ichoi02/MeowMentumV2/cmds.png

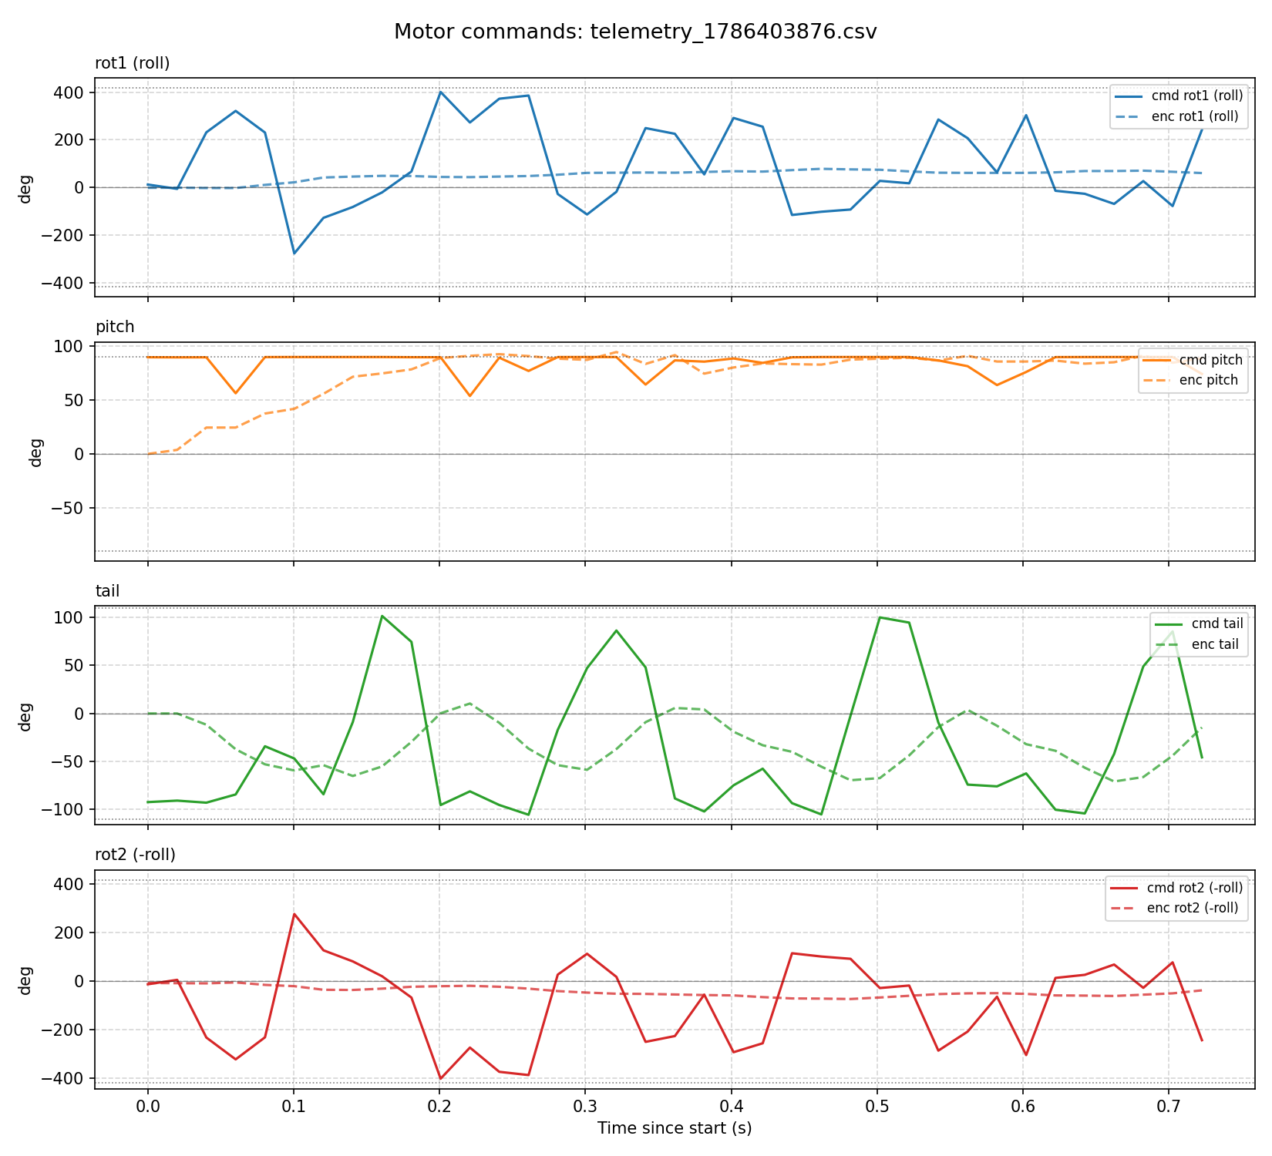
cmds.png
