ichoi02/MeowMentumV2/telemetry/sim2real_summary.png

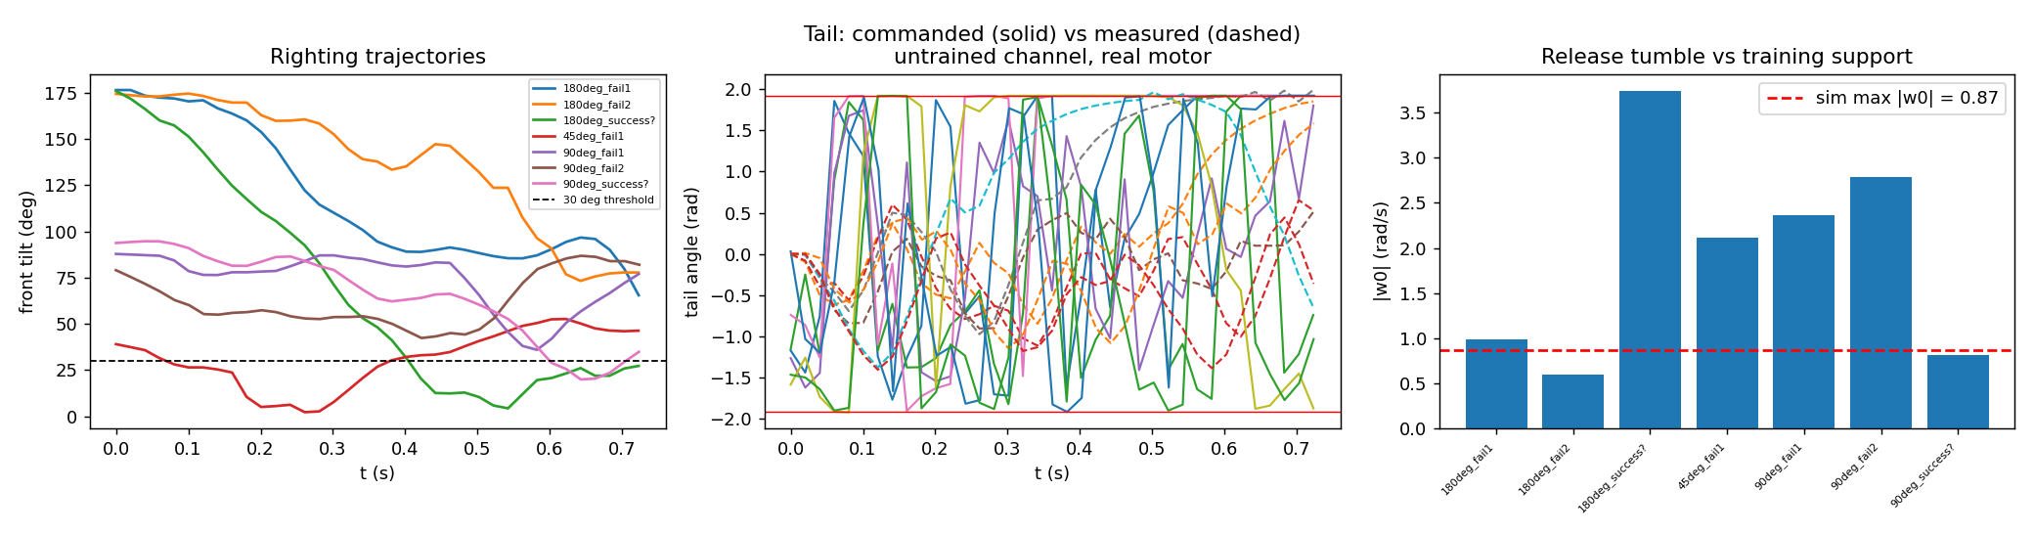
telemetry/sim2real_summary.png
