ichoi02/MeowMentumV2/telemetry/stage4_tracking.png

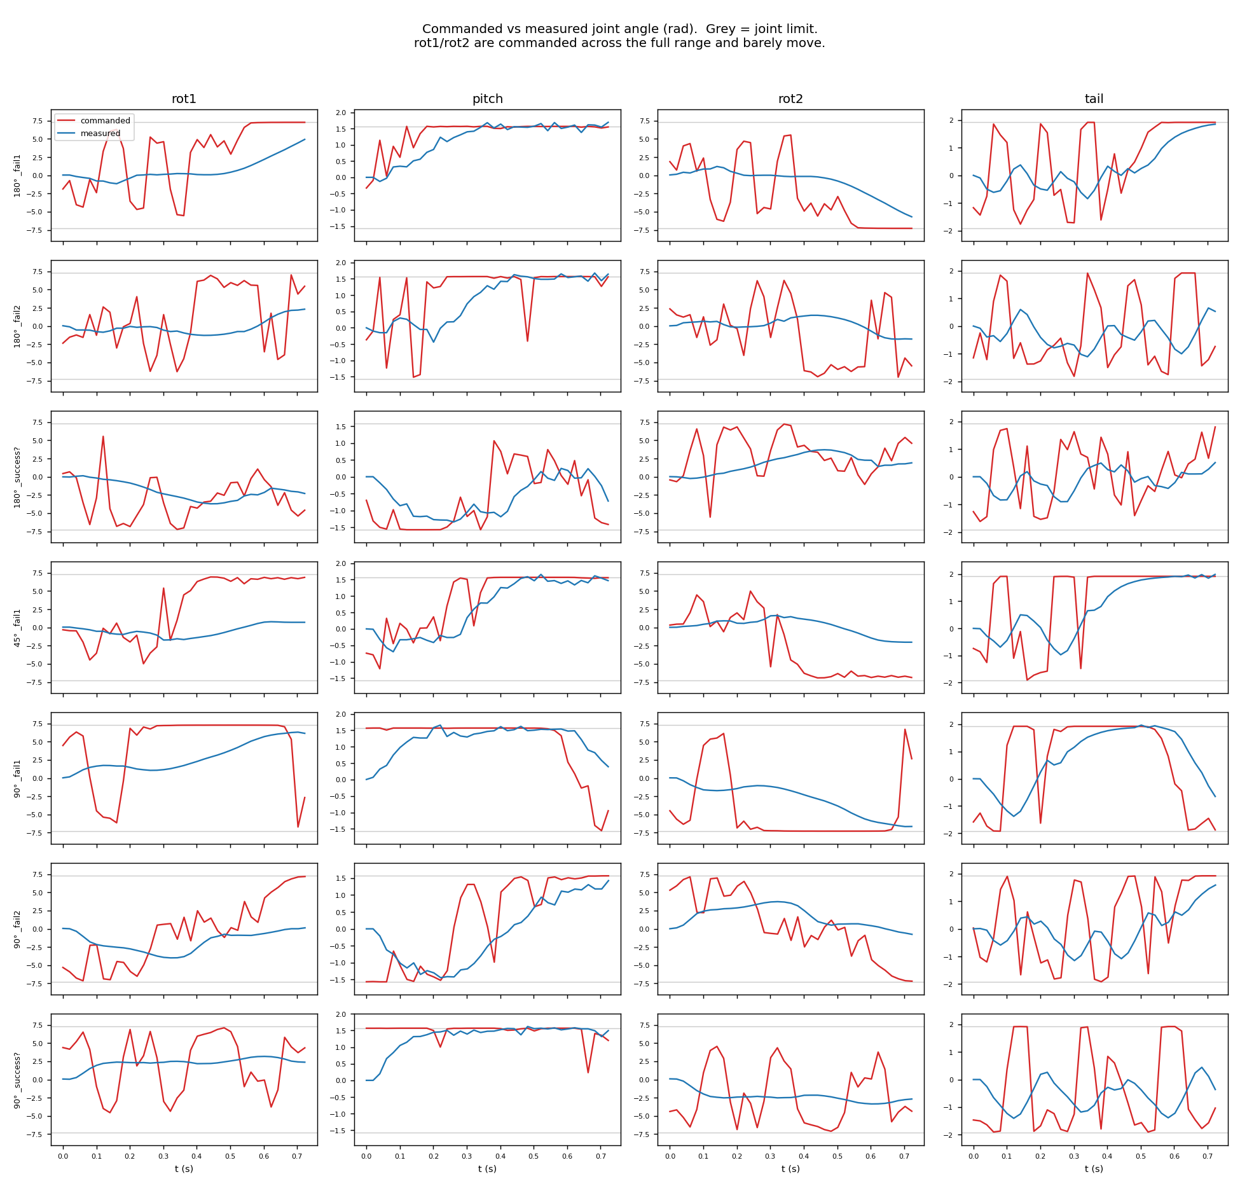
telemetry/stage4_tracking.png
