ichoi02/MeowMentumV2/telemetry/stage4_travel.png

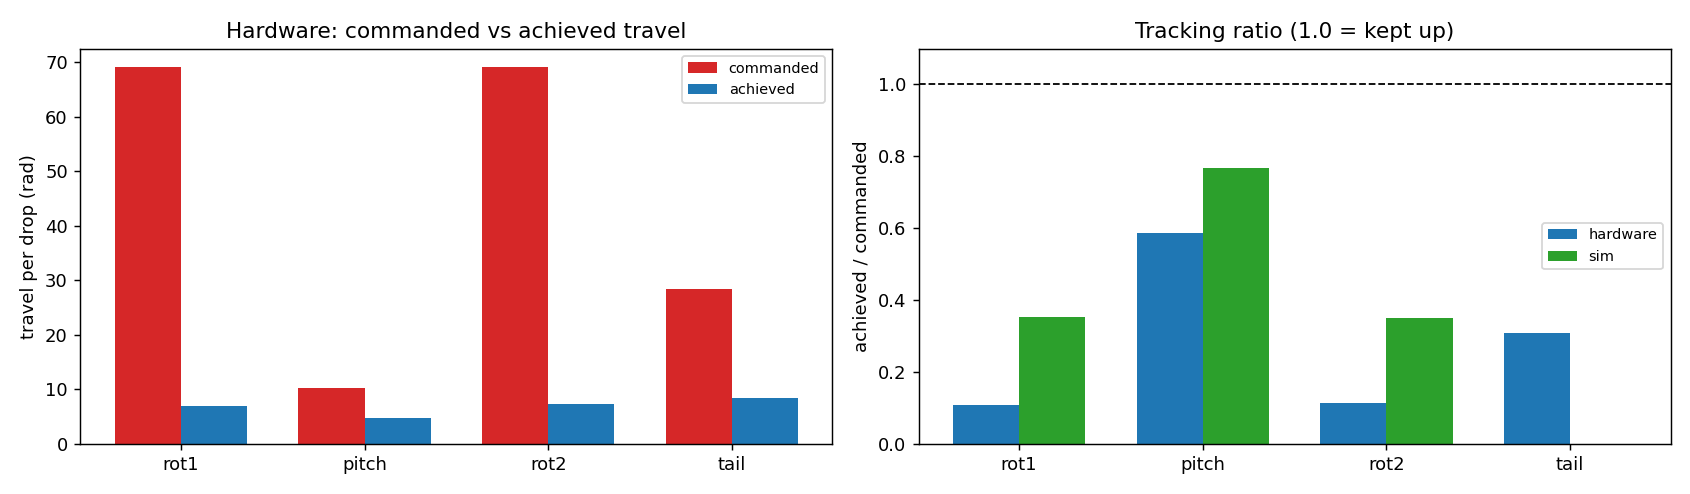
telemetry/stage4_travel.png
