ichoi02/MeowMentumV2/telemetry/stage6_obs_dist.png

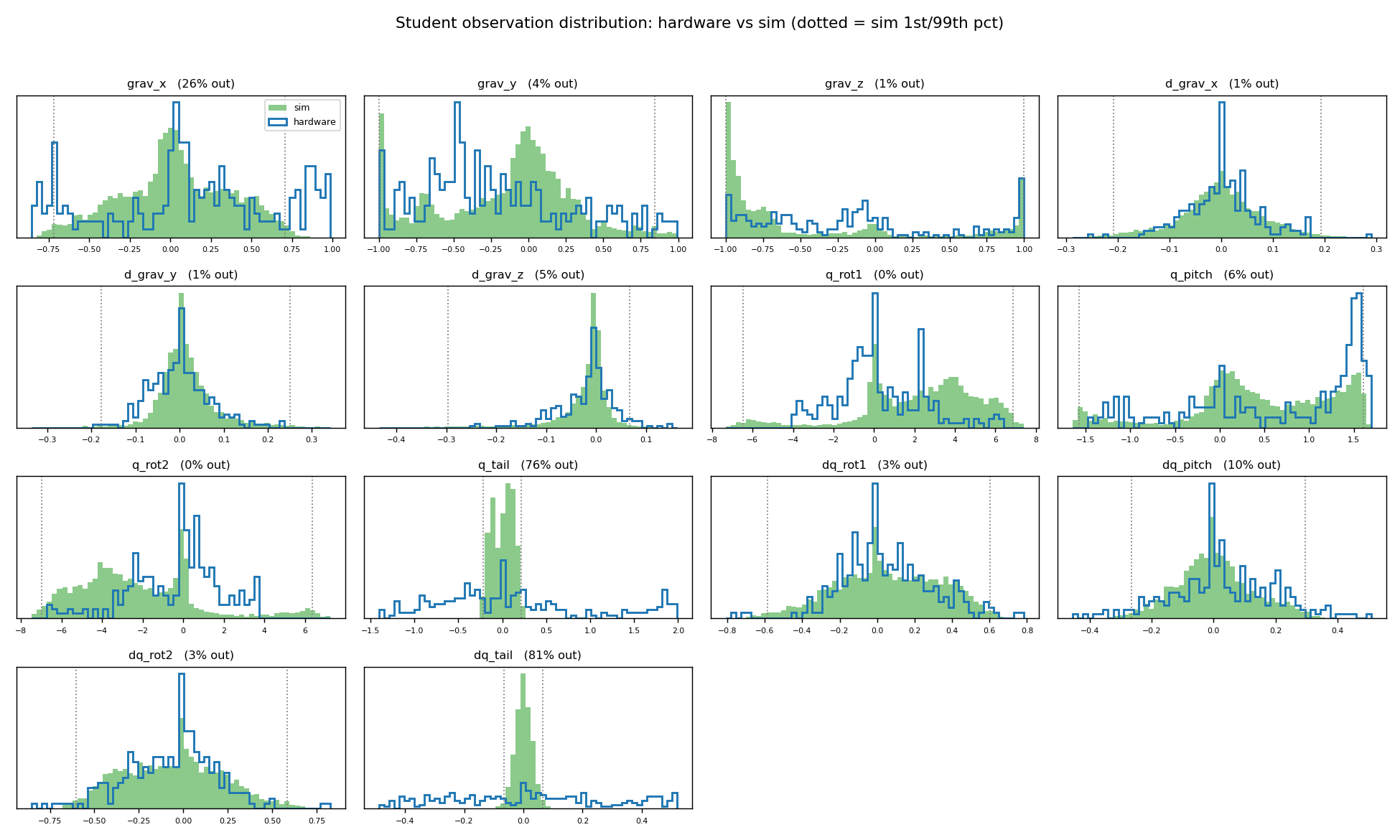
telemetry/stage6_obs_dist.png
