ichoi02/MeowMentumV2/telemetry/stage6_obs_velocity.png

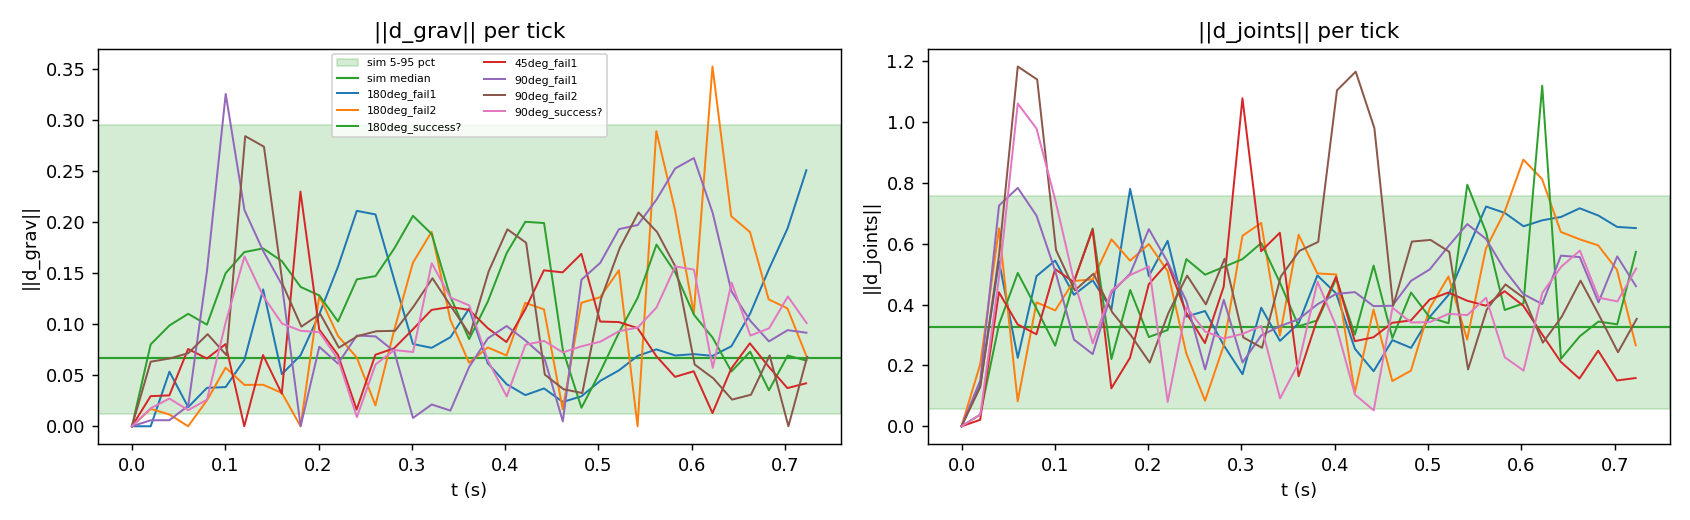
telemetry/stage6_obs_velocity.png
