ichoi02/MeowMentumV2/telemetry/stage9_actions.png

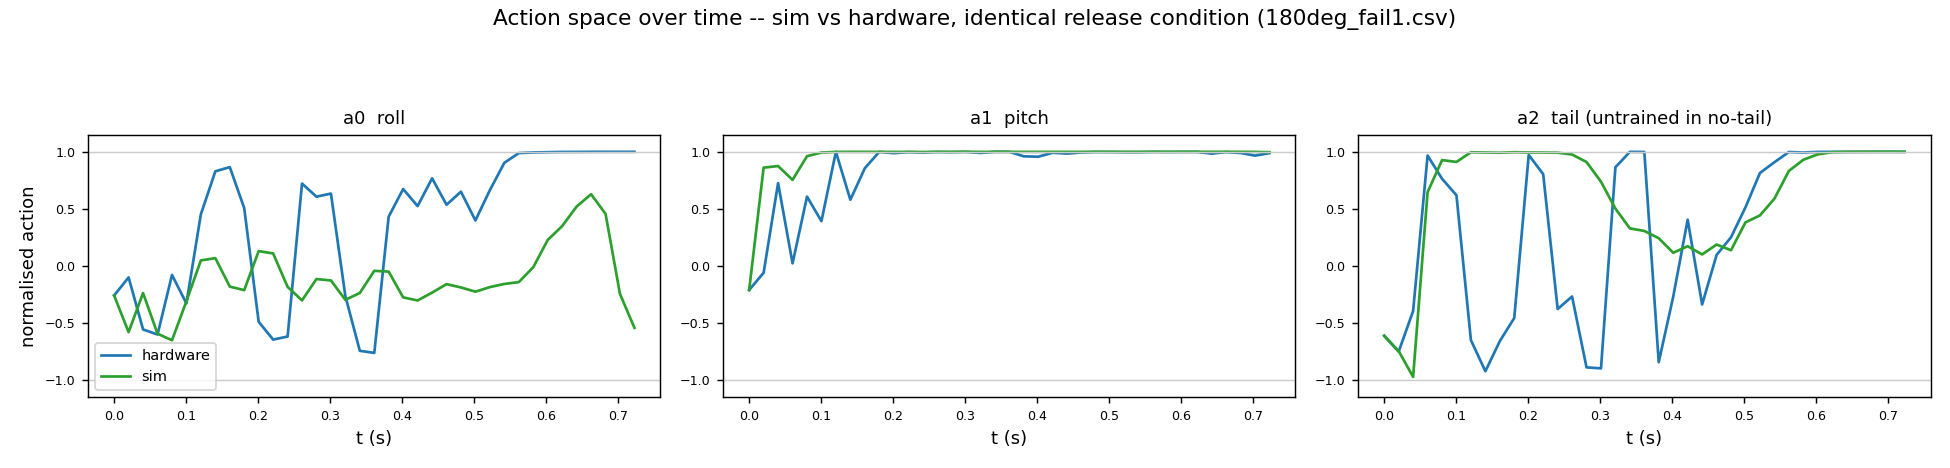
telemetry/stage9_actions.png
