ichoi02/MeowMentumV2/telemetry/stage9_observations.png

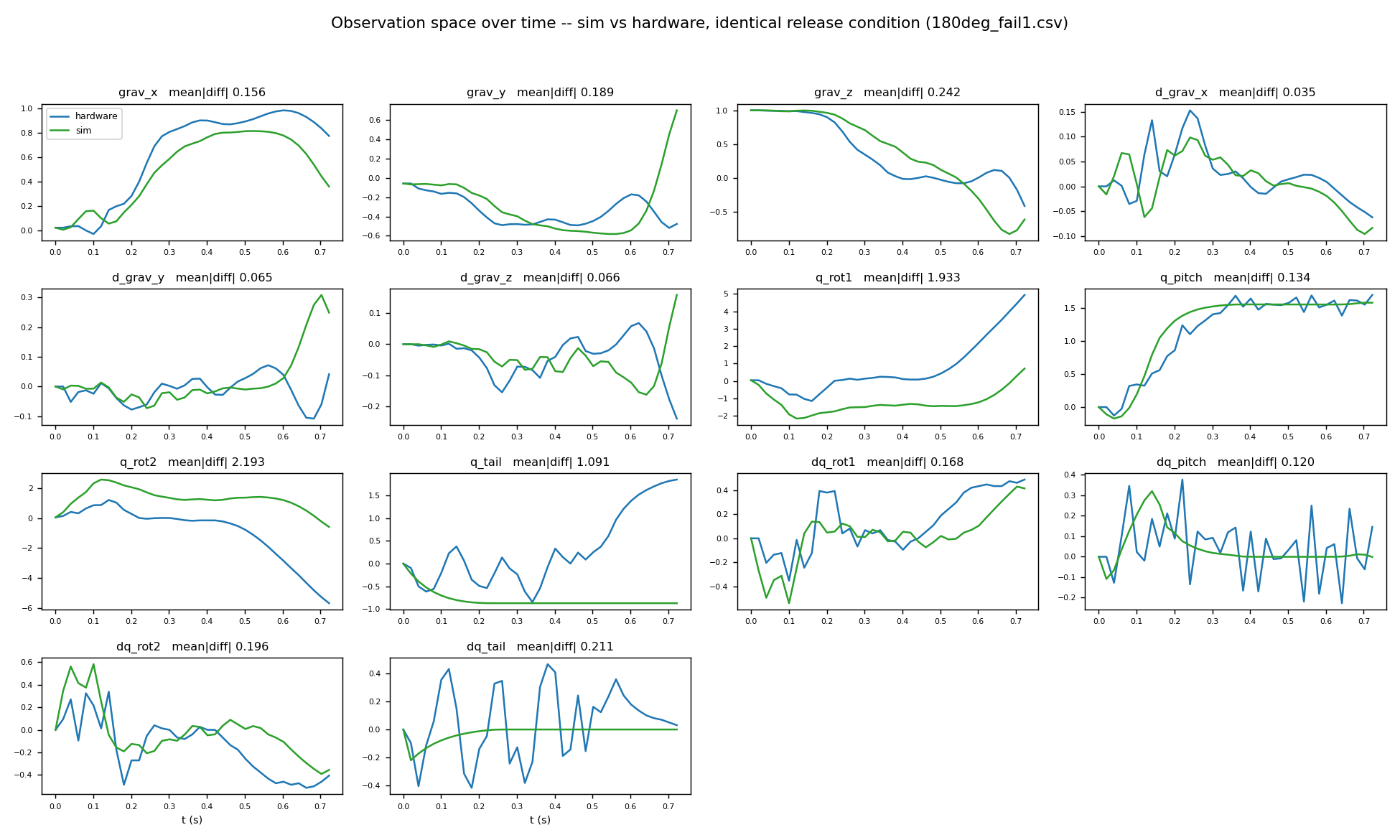
telemetry/stage9_observations.png
