ichoi02/MeowMentumV2/(commit log)

2026-07-24 Initial commit: MeowMentumV2 forked from MeowMentum
    Snapshot of the tuned sim: corrected body masses/inertias, per-joint
    datasheet-grounded damping/frictionloss/armature, sim-optimal PD gains,
    live action delay, and the retrained teacher (cat_controller.zip).
    [Apr17_r135.csv, Apr17_r135_2.csv, Apr17_r180.csv, Apr17_r90.csv, Apr18_r180_1.csv, Apr18_r180_2_failed.csv, Apr18_r180_3_not_good.csv, Apr18_r180_4_no.csv]
2026-07-26 V2 first commit
    [Apr17_r135.csv, Apr17_r135_2.csv, Apr17_r180.csv, Apr17_r90.csv, Apr18_r180_1.csv, Apr18_r180_2_failed.csv, Apr18_r180_3_not_good.csv, Apr18_r180_4_no.csv]
2026-08-07 0806 jot
    [180deg_fail1.csv, 180deg_fail2.csv, 180deg_success?.csv, 45deg_fail.csv, 45deg_fail1.csv, 45deg_success?.csv, 90deg_fail.csv, 90deg_fail1.csv]
